faludi/wind-lantern/enclosure/Lantern_Base_v1.1.stl

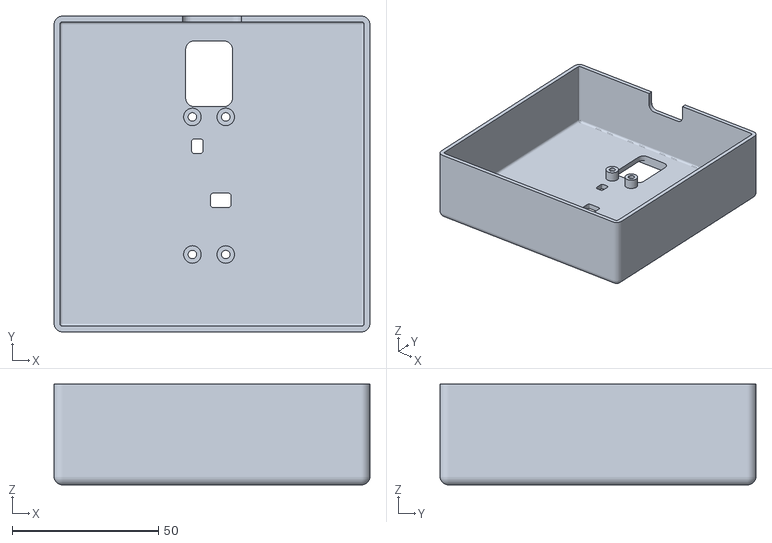
[picture p2: CAD file, 2026-10-30]
enclosure/Lantern_Base_v1.1.stl
108.0 x 108.0 x 34.5
