faludi/wind-lantern/enclosure/japanese_lantern_STYLE_2_BAMBU.3mf

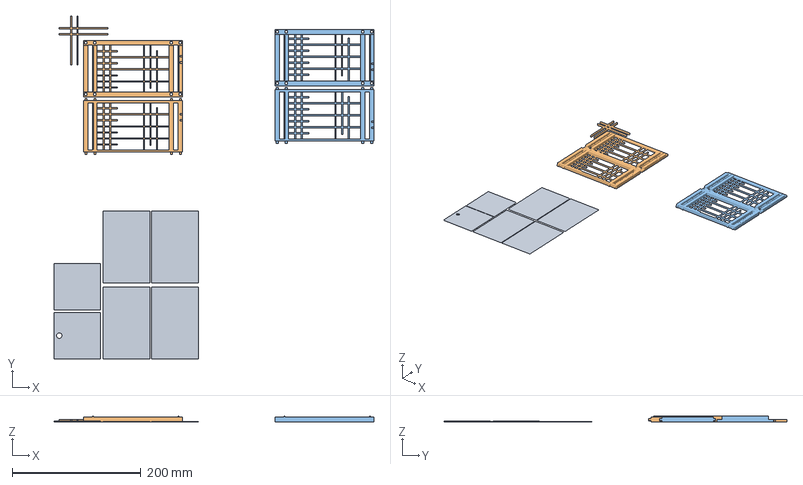
[picture p3: CAD file, 2026-10-14]
enclosure/japanese_lantern_STYLE_2_BAMBU.3mf
497.6 x 533.2 x 9.10 mm
japanese lantern PART 3.stl
japanese lantern full STYLE 2 P1.stl
japanese lantern full STYLE 2 P2.stl
