faludi/wind-lantern/hardware/lantern-lights.kicad_pcb

## KiCad design hardware/lantern-lights.kicad_pcb (2026-10-18)

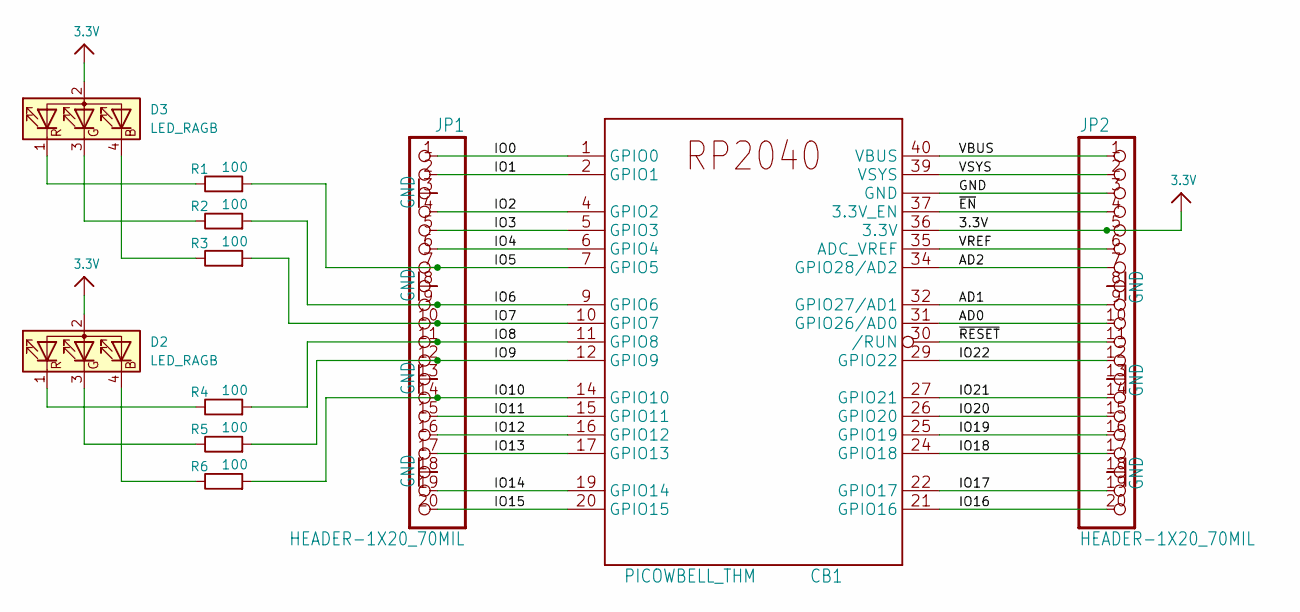
[picture p4: schematic lantern-lights.kicad_sch]

Parts:
CB1: PICOWBELL_THM; PICOWBELL
D2, D3: LED_RAGB; LED_D5.0mm-4_RGB
JP1, JP2: HEADER-1X20_70MIL; 1X20_ROUND_70MIL
R1, R2, R3, R4, R5, R6: 100; R_0805_2012Metric_Pad1.20x1.40mm_HandSolder; LCSC C4310

Connections:
3.3V: CB1.36 (3.3V), D2.2 (A), D3.2 (A), JP2.5
/AD0: CB1.31 (GPIO26/AD0), JP2.10
/AD1: CB1.32 (GPIO27/AD1), JP2.9
/AD2: CB1.34 (GPIO28/AD2), JP2.7
/IO0: CB1.1 (GPIO0), JP1.1
/IO1: CB1.2 (GPIO1), JP1.2
/IO2: CB1.4 (GPIO2), JP1.4
/IO3: CB1.5 (GPIO3), JP1.5
/IO4: CB1.6 (GPIO4), JP1.6
/IO5: CB1.7 (GPIO5), JP1.7, R1.2
/IO6: CB1.9 (GPIO6), JP1.9, R2.2
/IO7: CB1.10 (GPIO7), JP1.10, R3.2
/IO8: CB1.11 (GPIO8), JP1.11, R4.2
/IO9: CB1.12 (GPIO9), JP1.12, R5.2
/IO10: CB1.14 (GPIO10), JP1.14, R6.2
/IO11: CB1.15 (GPIO11), JP1.15
/IO12: CB1.16 (GPIO12), JP1.16
/IO13: CB1.17 (GPIO13), JP1.17
/IO14: CB1.19 (GPIO14), JP1.19
/IO15: CB1.20 (GPIO15), JP1.20
/IO16: CB1.21 (GPIO16), JP2.20
/IO17: CB1.22 (GPIO17), JP2.19
/IO18: CB1.24 (GPIO18), JP2.17
/IO19: CB1.25 (GPIO19), JP2.16
/IO20: CB1.26 (GPIO20), JP2.15
/IO21: CB1.27 (GPIO21), JP2.14
/IO22: CB1.29 (GPIO22), JP2.12
/VBUS: CB1.40 (VBUS), JP2.1
/VREF: CB1.35 (ADC_VREF), JP2.6
/VSYS: CB1.39 (VSYS), JP2.2
/~EN: CB1.37 (3.3V_EN), JP2.4
/~RESET: CB1.30 (/RUN), JP2.11
GND: CB1.3 (GND), CB1.8 (GND), CB1.13 (GND), CB1.18 (GND), CB1.23 (GND), CB1.28 (GND), CB1.33 (GND), CB1.38 (GND), JP1.3, JP1.8, JP1.13, JP1.18, JP2.3, JP2.8, JP2.13, JP2.18
unnamed: D2.4 (BK), R6.1
unnamed: D2.3 (GK), R5.1
unnamed: D2.1 (RK), R4.1
unnamed: D3.4 (BK), R3.1
unnamed: D3.3 (GK), R2.1
unnamed: D3.1 (RK), R1.1

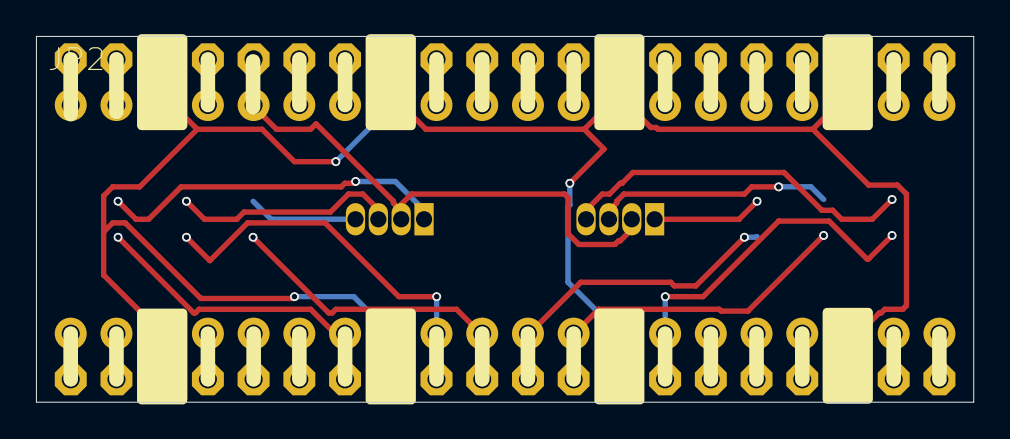
[picture p5: board lantern-lights.kicad_pcb from above]

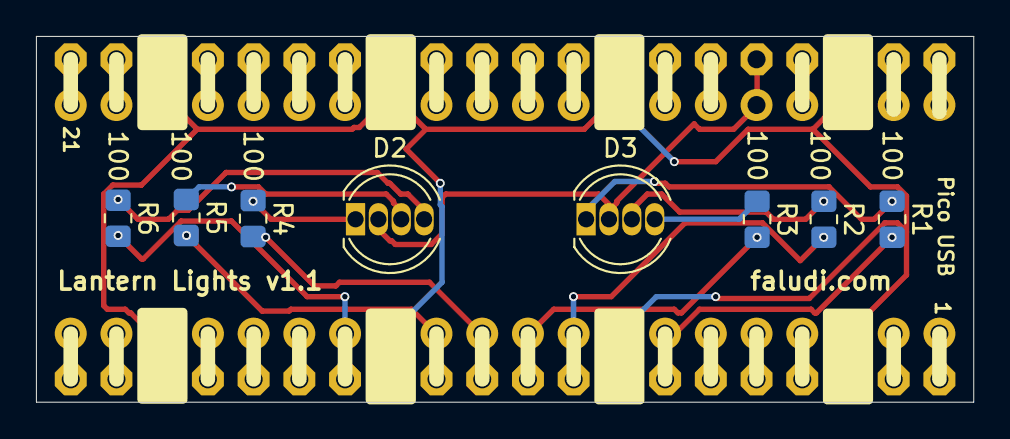
[picture p6: board lantern-lights.kicad_pcb from below]

Board: 2 copper layers, 52.1 x 20.3 mm, 11 parts (8 on the bottom side), 39 nets.
