faludi/wind-lantern/(commit log)

2025-10-02 remove troublesome irq and replace with polling plus thread locking
    [Wind_Sensor_BLE.py]
2025-10-07 add mode switch and garbage collection
2025-11-05 add error light output
    [Wind_Lantern_WiFi.py]
2025-11-05 remove debugging printout
2026-09-02 color temperature setting
2026-09-17 additional range for color temperature
2026-09-25 Improvements to admin and bugfix to settings lookups
    [Wind_Lantern_BLE.py, Wind_Lantern_WiFi.py, Wind_Sensor_BLE.py, main.py]
2026-09-27 Refactor settings hints for clarity and consistency; limit flicker intensity to 5, create reboot backoff, reorganize online settings, add interface widgets...
    [main.py]
2026-10-24 Update firmware version and enhance Wi-Fi provisioning page with device MAC and firmware details
2026-10-24 Update version to 1.0.54 and refactor PWM duty cycle settings
2026-10-24 Refactor PWM duty cycle settings to apply after reboot backoff
2026-10-24 Reapply reboot backoff after setup button press to ensure proper state management
2026-10-26 Update version to 1.0.56 and adjust timer initialization for firmware update feeding
2026-10-30 Update Lantern_Base_v1.1.stl model file
2026-11-03 Enhance firmware update process with watchdog timer and memory management improvements
2026-11-03 Update version to 1.0.63 and enhance firmware update process with candle thread management
2026-11-03 Add refresh button to Wind Lantern Administration page
2026-11-03 Add navigation and refresh button to Wind Lantern Administration page
2026-11-03 Update version to 1.0.64 and refactor blue LED initialization
2026-11-04 Refactor Wind Lantern firmware and architecture
    - Updated README.md to provide detailed project overview, architecture, and device setup instructions.
    - Changed settings endpoint in config.json to point to the new PHP check-in script.
    - Modified index.php to reflect updated settings update interval range.
    - Refactored lantern_config.py to improve normalization functions for various settings.
    - Simplified main.py by integrating LanternHardware and WindManager classes, removing redundant code.
    - Created lantern_hardware.py to encapsulate hardware control logic for LEDs and setup button.
    - Introduced settings_store.py for loading and saving configuration settings.
    - Added testing suite for lant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
2026-11-06 Enhance LED control and update Wi-Fi portal instructions; add tests for new features
2026-11-10 Add temperature control UI and enhance night brightness settings
2026-11-10 Update color temperature and flicker intensity hints for clarity
